mickymuis/drowbot/README.md

drowbot logo Drowbot
Drowbot is a polar drawing robot that uses a RaspberryPi-zero as its heart of processing.

pinout diagram pinout for the RJ-45 connector
