mickymuis/drowbot/report/report.tex

% !TEX TS-program = xelatex
% !TEX encoding = UTF-8 Unicode

\documentclass[a4paper,10pt]{article}

\usepackage[english]{babel}
\usepackage{graphicx}
\usepackage{subcaption}
\usepackage{wrapfig}
\usepackage{amsmath}
\usepackage[hidelinks]{hyperref}
\usepackage[margin=40mm]{geometry}

\hypersetup{
  unicode=true,
  pdftitle={Robotics paper},
  pdfsubject={Drowbot - A Suspended Polar Plotting Robot},
  pdfauthor={Micky Faas, Koen Putman},
  colorlinks=false,
  breaklinks=true
}
\usepackage{fontspec}
\defaultfontfeatures{Ligatures=TeX}
\usepackage[small,sf,bf]{titlesec}
% Times New Roman takes up less space so we can fit more text in fewer pages :)
\setromanfont{Times New Roman}
\setsansfont{Arial}
\setmonofont[Color={0019D4}]{Courier New}

% TODO: Add more citations in general because the paper is too long anyway
% TODO: clean the code a bit to make sure it's deliverable

% Converted logo SVG to eps so we lose the aliasing
\title{\vspace{-5.5em}
 \\ \vspace{.5em}
%\huge Drowbot
\Large \sffamily{A Suspended Polar Plotting Robot}}

% TODO: Whoops I don't know your student number
% No problem, I don't know it either :)
\author{Micky Faas (s1407937) \and Koen Putman (s1305557)}
\date{}

\begin{document}
\maketitle
\begin{abstract}
%TODO: Actually write this
% Micky: zo ouwehoer ik mijzelf dus een weg door het leven...
In the past, plotting-devices were usually very expensive specialised
equipment used by big printing studios.
% In recent years, the emergence of affordable embedded platforms such as Arduino and Raspberry Pi have given rise to a myriad of plotters that are available to the general public and DIY-community.
That changed with the emergence of affordable platforms like Arduino and the
Raspberry Pi, which have allowed the DIY-community to create a myriad of
affordable plotters for the general public.
Those plotters are used by hobbyists, tinkerers, print-makers, and artists that
want to explore the boundaries of man-machine synergy.
What most of these plotters have in common is that they are unidirectional
devices: they simply perform the drawing instructions they get from their
operator.
We introduce Drowbot, a bidirectional polar plotter.
By using optical feedback, Drowbot can expand, adapt and interpolate
directly on the canvas - allowing Drowbot to become a co-author rather than a tool.

%%% Original abstract from long ago
% There exist many different drawing- and writing robots. Examples
% include Axibot [1] or [2]. The most common constructions are either arm-based
% (single arm holding a pen) or have a plotter/CNC-style three-axis position pen.
% Practical implementation often utilize the GCode protocol to send drawing
% instructions to the robot; the robot itself lacks any ‘intelligence’, which basically
% makes it a printer/plotting-device. The ‘Maestrobot’ differentiates itself by being
% able to create its output untethered. It is equipped not only with a pen/marking-
% tool, but also with a simple optical sensor (infrared-led-photodiode). Using
% this sensor, the Maestrobot can ‘see’ what is already on the paper and use this
% information to decide where/what to draw next. Different algorithms could
% be suitable to add ‘intelligence’ to the robot’s drawing expertise. For example,
% cellular automata could be used to finish a given start sequence or the input could
% be combined with Perlin noise to create interesting textures. Eventually the
% robot could be used to perform certain difficult or tedious tasks in human-made
% art. These include repeating structures, fractals or extremely fine lines, given an
% algorithm specified by the artist.
% [1] https://www.axidraw.com/
% [2] https://www.thingiverse.com/thing:2349232
\end{abstract}

\section{Introduction}
\label{sec:intro}

% Micky: ik knip dit er even uit, we hebben *veel* teveel pagina's en dit staat ook soort-van in de abstract
%While some might consider drawing a distinctly human art form,
%many tools have been devised to assist in the process.
%In recent years there has been a shift to digital with drawing
%tablets and drawing software and it is not unusual for a drawing
%to never exist outside of the digital realm.
%This digital realm is very convenient, but why stop there.
%Our increasingly digital lives have brought us electronics that
%allow the digital to act in the real world, including the robot.

Many drawing robots have been devised to automate tedious and
repetitive parts of the artistic (printing-) process.
These include drawings arms and three-axis CNC-like solutions that
act as some form of plotter.
But we believe that robots do not have to be deterministic plotters
and wanted to see if they could interact with artwork and produce
drawings without pre-programmed or direct control.
Is it viable to give a drawing robot some agency to produce some
form of art on its own?

\section{Project Overview}
\label{sec:overview}
% Description and goals of the project

We set out to create a drawing robot that is partially controlled by
optical feedback.
With our limited amount of time and a live prototype presentation
on the horizon we had to set some constraints to make this possible.

Given that the live demo was held in a classroom the only viable drawing
surface was the blackboard, as transporting a large amount of surface
to draw on was infeasible.

Using the vertically mounted blackboard as surface and chalk as
end-effector seemed to have left us with a single viable approach:
using a suspended drawing platform or \emph{gondola} attached to the top corners of the
blackboard using cables, akin to a Delta 3D-printer but with fewer axes.
If we can vary the cable lengths and give the gondola a way to
disengage the chalk from the blackboard we end up with three
degrees of freedom.
Moreover, the camera on the gondola serves as a means to gather the
optical feedback we required.
We will provide an overview of the design in the next sections and
more details about our prototype design can be found in the appendix.

\subsection*{Related work and inspiration}
The class of plotters that includes our Drowbot is usually called \emph{polar plotter} after their internal use
of bipolar coordinates, which we will cover later on.
The \emph{Polargraph} \cite{polargraphsite} is probably the best known variant and this project also served as inspiration for some of the construction aspects of Drowbot,
but no code from this or any other existing polar plotter was used.
% TODO: figure out how to cite an in-document bibliography without warnings

%%% Code dependencies are probably pointless to list tbh
% The only library dependency of our code is the PIGPIO library for
% simplified GPIO and help with timing our signals, but replacing
% this would not be particularly hard.
% We also used the V4L2 drivers for the raspberry PI camera in order
% to grab images through the file descriptor interface.

% Micky: moved figure to appendix

Our prototype has a rather large physical presence as seen in Figure~\ref{fig:overview}.
In this section we will try and give an overview of the parts involved
while there is a more elaborate description in appendix \ref{sec:buildinst}.

\subsection*{Motors and cables}
% There is no better place to start than the reason why it (usually)
% does not fall apart.
The main body of these assemblies is mounted to the blackboard and
contains a stepper motor and a special pulley for the beaded chain.
We used the beaded chain because it is light and easy to hold firmly
on the pulley. That helps to ensure that it only moves when we want it to.

Both beaded chains connect to the middle of the gondola using ball-bearings.
This keeps the gondola upright regardless of the angle of the chains.
The chalk is placed in the tube that the bearings are mounted on so it is always
at the centre of the forces applied to to gondola.
Both the pulleys and the handles that connect to the bearing are 3D printed.
Designs for the 3D printed objects can be found on GitHub\cite{github}.

\subsection*{The gondola}
This ``moving platform'' is attached to the same chalk tube that we attached
the chains to.
It holds a good chunk of the electronics, like the Raspberry Pi Zero W
that we use to drive the entire thing and the camera we use to gather
optical feedback.
The gondola ``glides'' on the blackboard using nylon bolts as a form of
standoff or ``legs''.
Lifting the chalk to stop drawing is achieved by a mechanism that pushes the platform away from the
blackboard using a servo-motor.
To counteract the weight of the servo on the top of the platform
we added some counterweight to the bottom.

In order to power the electronics and send control signals back to the
motors up top, we need to run 7 separate wires. We made a
custom shield with an RJ45 socket on it, so we could conveniently run Cat 5e
cable to carry all of necessary signals.

\subsection*{Motor drivers and power delivery}
% Micky: Knip want ruimte
%On the other end of that Cat 5e cable is another piece of protoboard,
%the final piece of our design puzzle.

We used two DRV8825 drivers to simplify controlling the stepper motors.
These drivers allowed us to use a separate stronger power supply for
the motors while the rest of our electronics used a USB power supply.
This proved very useful when we needed to switch to stronger motors
to move and even hold the heavy platform.

\section{Functionality}
\label{sec:functionality}
% Micky: knip want ruimte
%While the physical design is impressive, the only thing it can do
%without software is hold its place on the board.
%The actual software component for this project is very light since
%driving the system is essentially just moving the servo between
%two preset positions and telling the drivers when to step and in
%which direction.

We will start this section by covering the core functionality and the
demo we built on top of that, before moving on to a short explanation
of some of the maths involved in the background.

% Micky: ja dit is niet netjes, maar het scheelt weer enorm veel ruimte.
%\subsection{Core functionality}
The Drowbot can interpret a section of the blackboard as a grid
and move feely within it using normal Cartesian coordinates.
For our demo we only use a very simple interface with a single
command telling it to move to specific coordinates while specifying
if it should draw or lift the chalk from the board, but much more
elaborate systems are technically in reach.

% Micky: moved figure to appendix

\subsubsection*{1D cellular automaton}

% TODO: cite stuff?
% Micky: added citation
% Micky: shorter rephrase
%We wanted a demonstration that shows a possible application of the
%optical feedback provided by the camera and with our relatively
%simple movement interface something simple like a one dimensional
%cellular automaton is a perfect fit.

The one-dimensional cellular automaton\cite{elemca} is the perfect
tool to demonstrate the application of optical feedback on the Drowbot.

We start by drawing a number of boxes on the board which can be
filled to provide a visual representation of the initial state.
After the initial state has been created the
Drowbot will read the initial state using the camera.
A user is then invited to enter a \emph{Wolfram code}\cite{elemca} of their liking
and the Drowbot will then draw the rest of the generations
using the user provided initial state and rule.

An image of a resulting drawing can be seen in Figure~\ref{fig:ca_res}.

% Micky: we're not making excuses :) And it saves space. (When did I switch to English anyway?)

%The boxes are filled with a Z pattern to save time while drawing.
%There are some extra diagonal lines in the image because the system
%for lifting the chalk to stop drawing was not perfectly tuned.

\subsubsection*{Dragon curve}

% TODO: cite stuff?
% Micky: added citation
The simple movement interface of Drowbot is very similar to
turtle graphics and we can emulate most of the turtle graphics
functionality with it.
We wanted to show how this robot can help people with drawing
repetitive structures like fractals, and have ported the turtle
graphics code for the \emph{Heighway dragon curve}\cite{dragon} to run on Drowbot.

The resulting image can be seen in Figure~\ref{fig:drag_curve}.

\subsubsection*{Maths}
% Problem solved (or more specifically, moved)
Moving the gondola over the board is done by varying the lengths of the
chains on both sides in order to reach the desired position.
So our coordinate system represents a position as two distances from
the steppers which are mounted in fixed positions.
This is the bipolar coordinate system~\cite{bipolar} we mentioned earlier,
which is very different from the Cartesian coordinates we use for our
drawing interface.
To handle the translation between these systems we have to calibrate
the device using measurements for the chain lengths and how far the
stepper motors are apart, as well as the length of a stepper motor
step.
When calibrated properly the precision of the system is about as good
as it gets for chalk on blackboard.

More details and a simple example can be found in Appendix~\ref{sec:maths}.

\section{Conclusion and discussion}
\label{sec:conclusion}

% Micky: yep, modesty and self-deprecation can be saved for a much-needed later occasion :)

%In some miraculous fashion we managed to achieve all the lofty goals
%we set for this project.
%We have a functioning drawing robot that can read something from
%the blackboard and act based on whatever it saw on its own without
%direct input.

%This project was a lot of fun, but it also ended up costing both
%member a large part of the month we spent creating this.

% Micky: this one comes right out of my collection of standard NT sentences I keep in a yar.
The design of the Drowbot was challenging yet rewarding experience
and we are glad to have met most, if not all, of the goals we had initially set.
Almost every step of the way we faced a new setback and almost all
of the initial parts of the design were replaced in the process.
The end result worked so much better than we could have dreamt,
especially considering all the setbacks.

Although we did end up with a working prototype, there are various obvious
improvements we have to make in order to get it closer to a production model.
Future work includes removing it from its blackboard and chalk
constraints and see what it can do on a medium that is
more controlled and easier to move in, such as ink on paper.
We also want to look for or devise more algorithms where the optical
feedback system could play a more significant role.

\begin{thebibliography}{9}
%TODO: MORE CITING
% Micky: Added Wolfram/1d CA and Dragon curve

\bibitem{polargraphsite}
  \textit{Polargraph}, Sandy Noble
  \\\url{http://www.polargraph.co.uk/}

\bibitem{github}
  \textit{Drowbot GitHub repository}, Micky Faas, Koen Putman
  \\\url{https://github.com/mickymuis/drowbot}

\bibitem{elemca}
Wolfram, Stephen:
\textit{``Statistical mechanics of cellular automata."}
In: Reviews of Modern Physics, Vol. 55.3: 601--644.
(1983)

\bibitem{dragon}
\textit{Dragon Cuve} on Wolfram Mathworld
\\\url{http://mathworld.wolfram.com/DragonCurve.html}

\bibitem{bipolar}
\textit{Bipolar Coordinates} on Wolfram Mathworld
\\\url{http://mathworld.wolfram.com/BipolarCoordinates.html}

\end{thebibliography}

\clearpage
\appendix

\section*{Photography}

\begin{figure}[h!]
  \centering
  \begin{subfigure}[t]{0.55\textwidth}
    \centering
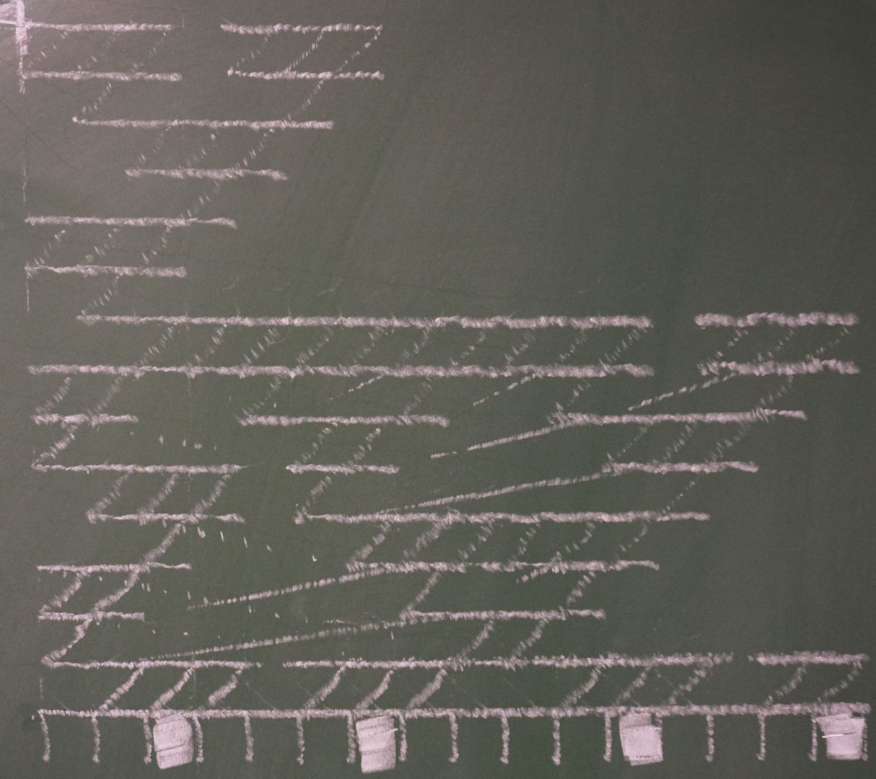
[picture p1: report/img/ca_res.jpg]
    
    \caption{Result from drawing a cellular automaton with Wolfram code 22}
    \label{fig:ca_res}
  \end{subfigure}
  \begin{subfigure}[t]{0.4\textwidth}
    \centering
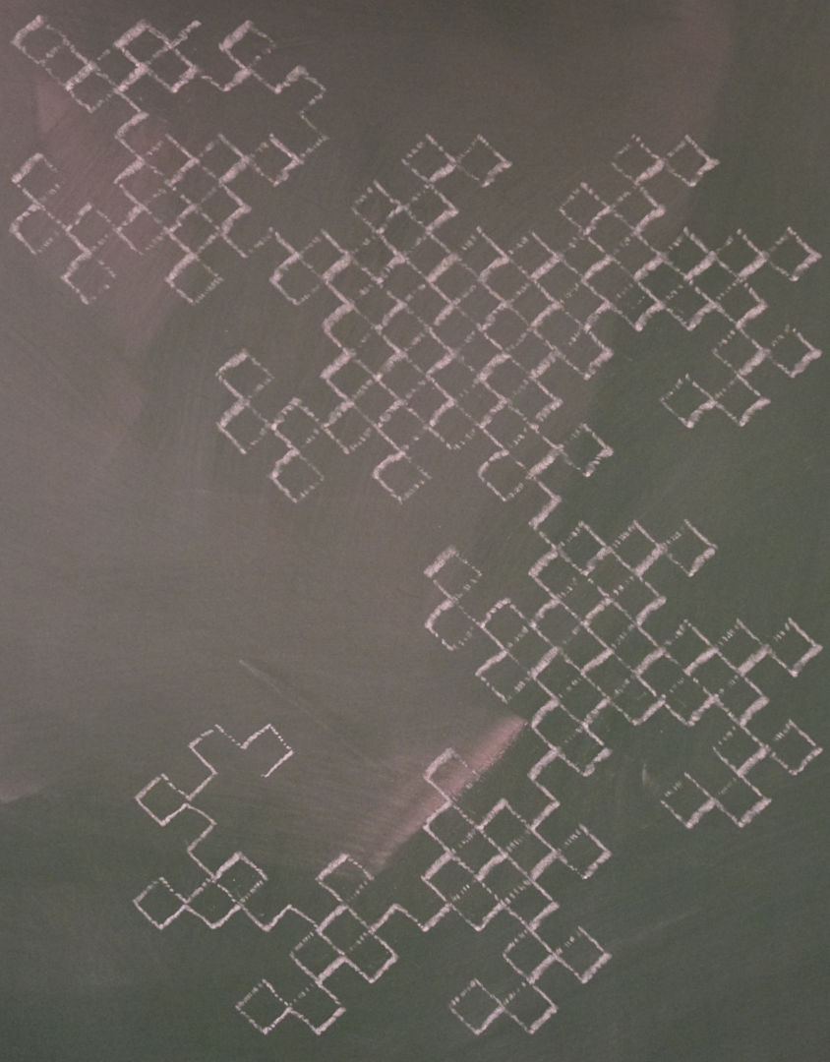
[picture p2: report/img/dragon_curve.jpg]
    
    \caption{A section of the dragon curve}
    \label{fig:drag_curve}
  \end{subfigure}
\end{figure}

\begin{figure}[h!]
  \centering
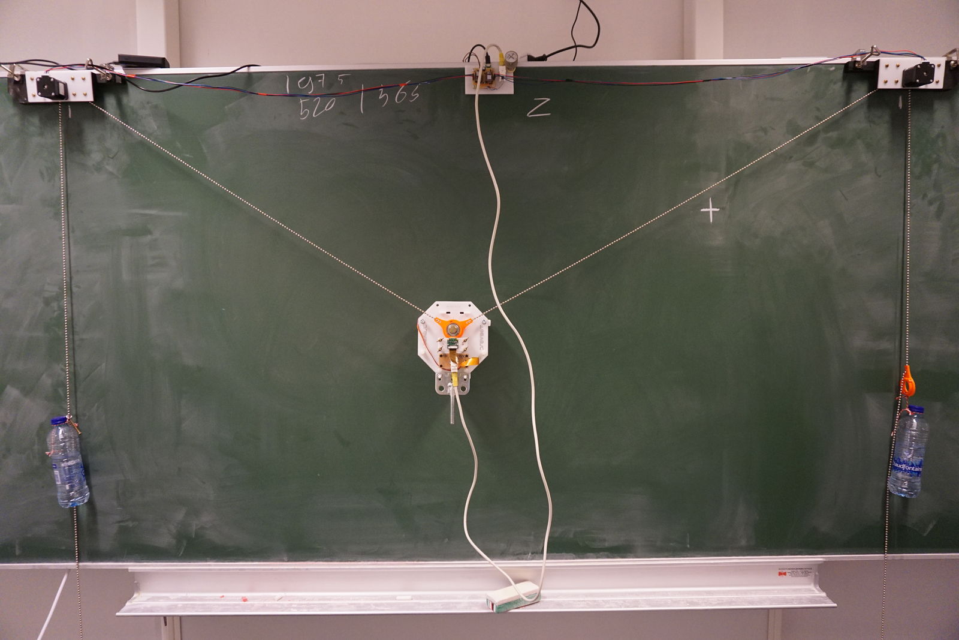
[picture p3: report/img/overview_rs.jpg]
  
  \caption{Drowbot deployed on a blackboard}
  \label{fig:overview}
\end{figure}

% Appendix I: An overview of the system requirements.
\clearpage
\section{System requirements}
\label{sec:sysreq}
The general requirements are a lot of time on your hands and a wide
arrangement of tools, but we will go into more details about what
we used in this section.

% TODO: Is this comprehensive or did I forget some things
\subsection*{Motors and beaded chains}
\begin{itemize}
  \item A motor mount that can be clamped to the blackboard. We created brackets from wood and used five jigsaw clamps.
  \item NEMA 17 stepper motors (we used 1.8$^\circ$/step, 0.55N/M, 1.7A)
  \item Beaded chains (we used chrome, 4.4mm beads, 2mm apart)
  \item Several 3D printed parts (.stl available on GitHub)
  \begin{itemize}
    \item beaded chain pulleys for the stepper motors
    \item levers to attach the chains to bearings on the platform
    \item eyelets attach a counterweight to the chain
  \end{itemize}
  \item Counterweights (we used water bottles filled to aprox. 250 mL)
\end{itemize}

\subsection*{The gondola}
\begin{itemize}
  \item The platform itself (printable template SVG available)
  \item A Raspberry Pi Zero W or equivalent with
  \begin{itemize}
    \item at least 5 GPIO pins (2x step, 2x dir, 1x servo PWM)
    \item a picamera or other camera with V4L2 drivers
    \item an SD card with a Linux-based ARM OS (e.g. archlinuxarm)
    \item the ability to compile and use the PIGPIO library (or
          willingness to port the code to use some other GPIO library)
  \end{itemize}
  \item A custom shield for the Pi with
  \begin{itemize}
    \item A Female RJ45 connector to receive power and send signals
    \item Some way to connect the servo to power and the PWM pin
    \item Connections to several other GPIO pins for motor control
    \item Power distribution to the Pi and servo
    \item A 3.3V signal to send up from the Pi to the motor drivers
  \end{itemize}
  \item A servo to lift the chalk of the blackboard (like a MG996R). The template may need to be adapted for differently sized motors.
  \item A spring powered bar for the servo to push against. We used a bar made of 4 mm acrylate, with two M6 holes that line up with the corresponding holes in the gondola. Two springs and two long M6 hex bolts with ~30 mm flat shaft are also required.
  \item A camera mount for your camera. We used a PiCamera held by a piece of acrylate.
  \item A tube to mount the end-effector in (we used 10 mm chalk).
  \item Ball bearings to hold the chain handles. We used bearing that could fit over a 12 mm tube, measuring 32x10 on the outside. The OpenSCAD template can be easily modified to accommodate other sizes.
  \item M6 Nylon bolts to use as standoffs for the platform
  \item Standoffs to attach the Pi and the custom shield
  \item Many other nuts and bolts for various purposes, mainly to attach the camera (M3 for the platform, the PiCamera holes are M2).
  \item Some weight to hold the bottom of the platform down
\end{itemize}

\subsection*{Motor drivers and power delivery}
\begin{itemize}
  \item A power supply for the Pi/Servo (we used 5V USB with at least 2A)
  \item A motor power supply (we used one with 19V, 3.16A)
  \item A 100 \textmu F capacitor to smooth current between motor power and ground
  \item Two DRV8825 Stepper Motor Drivers (or equivalent)
  \item Two RJ45 sockets to attach the Cat 5e cable
  \item We used protoboard to create a shield for the RasberryPi in order to route the used pins to the RJ45. The motors drivers are mounted on a second protoboard, also containing a female RJ45 socket and an micro-usb socket for 5V supply.
\end{itemize}

%Appendix II: Complete and very clear instructions on how to get your
% demo working.
\clearpage
\section{Build instructions}
\label{sec:buildinst}

\subsection{Building the gondola}

\begin{figure}[h!]
  \centering
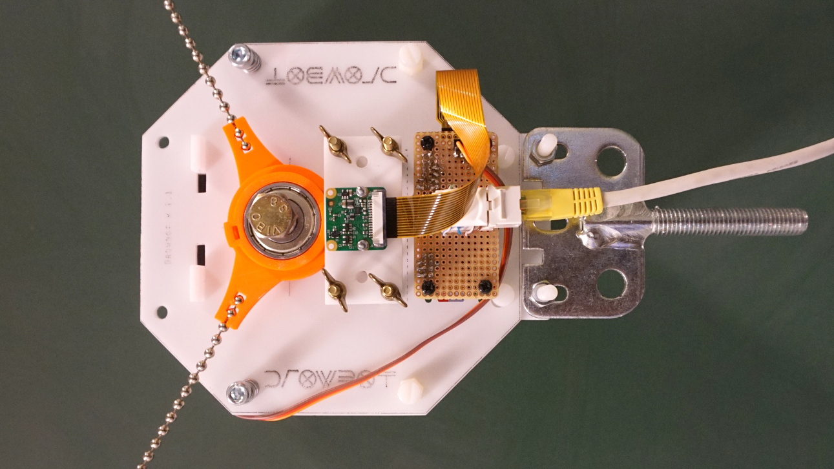
[picture p4: report/img/gondola.jpg]
  
  \caption{Assembled and attached gondola}
  \label{fig:gondola}
\end{figure}

\textbf{Step 1.} The gondola consists of a baseplate from acrylate with several components mounted on top of it.
The first step is to cut/drill out the baseplate from 4 mm acrylate using the template in Figure~\ref{fig:baseplate}. An SVG with more accurate dimensions can be found on GitHub\cite{github} and printed \emph{mirrored} using a \emph{laser} printer. We then transfer the print to a piece of well-sanded acrylate using the thinner-method\footnote{In a thinner-print, thinner is used to dissolve the cellulose in the paper and firmly attach the remaining toner to the printed surface.}.

\textbf{Step 2.} The next step is to mount the electronics. The camera is mounted on a piece of rectangular acrylate, with holes that correspond to the holes on the baseplate marked ``camera''. Make the appropriate holes to fit your camera. The assembly is then mounted using long M3 bolts and winged nuts to set the desired distance. The RaspberryPi (with shield, see below) can be put on M3 standoffs in the corresponding holes.

\textbf{Step 3.} The servo is fit at the top, but the precise method depends on the servo used. In the design, two rectangles are marked to be cut out. These cut-outs can be used to either fit ``hooks'' from acrylate that hold the servo, or simply use tie-wraps. The hooks we used are matched to the holes in the servo, which accommodate four M3 bolts to hold the servo in place.

\textbf{Step 4.} The four most outward M6 holes are for the legs of gondola. The bottom legs are simple M6 bolts fitted with nylon cap-nuts. The upper legs can be moved by the servo to lift the pen. For this we have fit a thin strip of acrylate with corresponding holes to spring loaded bolts. We use slightly longer bolts here that have a partially thread-less shaft in order to move through the holes without friction.

\textbf{Step 5.} The lower two holes can be used to fit counterweight to the gondola. We needed to use approximately 200 grams. Note that the further the weight is placed \emph{above} the gondola, the more pressure it applies to the bottom.

\textbf{Step 6.} Finally we attach the pen holder in the 12 mm hole of the baseplate. The pen holder conists of two ball-bearings measuring 32x10 mm, which are press-fit over the tube. The bearings are attached to the ball-chain using 3d-printed levers (orange on the photo). Lastly some means is needed to secure the pen in the tube. The chalk we used fitted exactly in the 10 mm inner diameter of the tube. We used an M10 bolt (with thread cut on the inside of the tube) to adjust the depth of the chalk.

% Micky: ik heb maar PNG gedaan want ik had geen zin om met LaTeX te vechten om mijn SVGs...
% Koen:  Inkscape kan naar eps exporteren, dus dat is mijn standaard strategie
\begin{figure}[p]
  \centering
  
  \caption{Design template for the gondola baseplate}
  \label{fig:baseplate}
\end{figure}

\begin{figure}[p]
  \centering
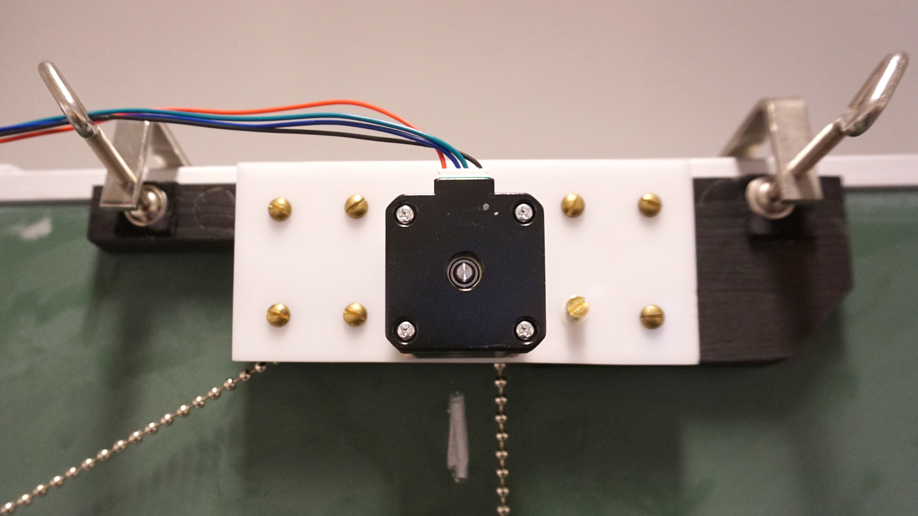
[picture p5: report/img/motorsusp.jpg]
  
  \caption{Assembled and attached motor suspensions}
  \label{fig:motors}
\end{figure}

\subsection{Building and attaching the motor suspensions}

The motor suspensions in are simple brackets (in our case, of wood) that hold an acrylic NEMA-17 faceplate. The thickness of the brackets is approximately 30 mm and should be chosen in such way that the pulleys almost touch the board. The brackets are also cut in such way that the chain can move unobstructed to one side (thus, the left and right brackets are mirrored).

Mounting the brackets depends on the medium it has to print on. Jigsaw clamps are a practical solution for mounting to (black-)boards with a thickness between 10 and 30 mm.

You can see a fully assembled example in Figure~\ref{fig:motors}.

\subsection{Wiring the RaspberryPi shield}

The shield for the RaspberryPi is relatively simple as it is simple used to route a number of GPIO pins to the servo and RJ45 socket. Figure \ref{fig:pinout} provides a template for how to connect the different pins that we used to the RJ45 socket. In addition, a three-pin header is used to plug the servo motor to the board.

\begin{figure}[h!]
  \centering
  
  \caption{Pin-out used for the RJ45 wiring}
  \label{fig:pinout}
\end{figure}

\subsection{Constructing and wiring the driver assembly}

\begin{figure}[h!]
  \centering
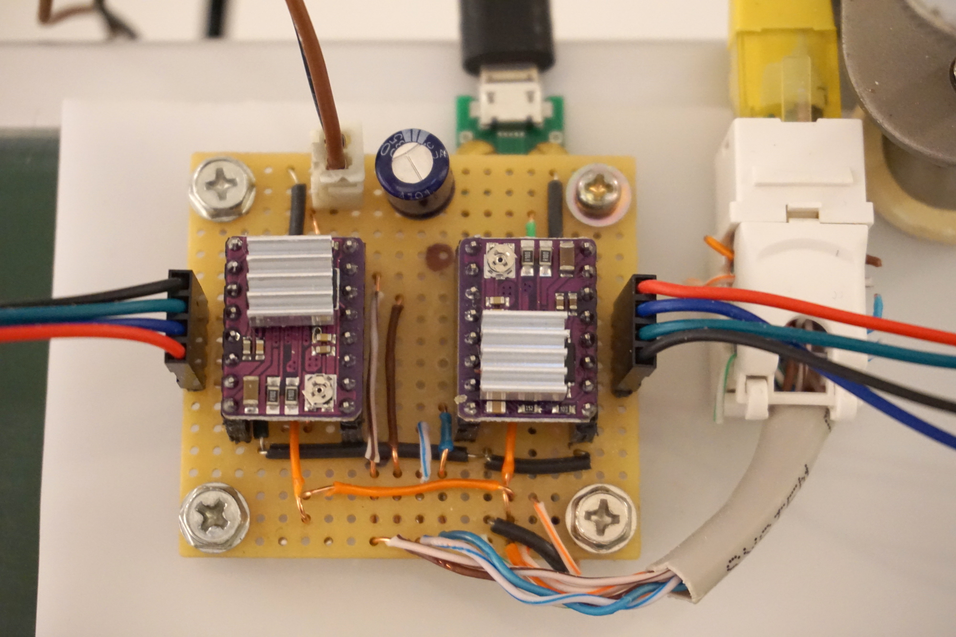
[picture p6: report/img/driverboard.jpg]
  
  \caption{Driver board with two DRV8825s, female RJ45, USB-power and separate motor power.}
  \label{fig:driverboard}
\end{figure}

The driver board can be attached to the top of the drawing surface and connects the gondola to the motors as well as power to the gondola. The main components are two pre-fabricated DRV8825 stepper-motor driver boards. Different boards could be used and it is necessary to consult the pinout of the drivers in question to wire them correctly to the power input and signals from the gondola. The connection with the gondola is made with the other side of the UTP cable that connects to the shield on the RaspberryPi. We decided to utilize two separate power supplies: one for the motors and one for the RaspberryPi and servo. In this design, one 5V line runs down to the gondola, while the RaspberryPi provides 3.3V back to power the logic circuit of the drivers. In hindsight, it is also possible to power the driver logic using the same 5V from the USB power supply, so that would free up one pin on the RJ45.

% TODO: I forgot how detailed this had to be but it sure needs to happen
% TODO: ADD SPECS FOR EVERYTHING, or at least some wiring info

\clearpage
\begin{figure}[t]
  \centering
  
  \caption{Mapping bipolar coordinates to Cartesian coordinates.}
  \label{fig:maths}
\end{figure}
\section{Maths}
\label{sec:maths}

To elaborate on the maths we have provided a small example image
in Figure~\ref{fig:maths}.
These maths are in no way advanced, but we think they are interesting
enough to warrant explaining in more detail.
The lines and labels in the example are colour coded so we will start
by explaining what they represent.

The black labels represent fixed constant values with $L$ and $R$
representing the stepper motors, and $Top$ the distance between them.

The blue $Left$ and $Right$ represent the chain lengths, the variables
we control directly.

The red $P$ represents the platform at position $(X,Y)$ in Cartesian
coordinates.

One of the nice constraints in our case is that $P$ will never be
left of $L$ or right of $R$ and will always be below $L$ and $R$ due
to gravity. This simplifies some of the calculations.

To calibrate our system we want to determine the position of $P$ based
on our measurements of $Left$, $Right$, and $Top$.
We will start by calculating $Y$, the height of the triangle $L,R,P$.

To get the height of a triangle for which you know all side lengths.
You can start by calculating its area using Heron's formula:
$$s = \frac{Top + Left + Right}{2}\qquad Area = \sqrt{s(s-Top)(s-Left)(s-Right)}$$
%
Now we can solve the equation for the area of a triangle for the height
and obtain $Y$:
$$Area = \frac{height \times base}{2} = \frac{Y \times Top}{2}
\quad \rightarrow \quad Y = \frac{2 \times Area}{Top}$$
%
We can then obtain the position of $X$ using the Pythagorean theorem:
$$X = \sqrt{Left^2 - Y^2}$$

Now that we know how to get from side length to coordinates we can
also go in the opposite direction and calculate how long $Left$ and
$Right$ need to be to get $P$ to a given $X,Y$.
This is another simple application of the Pythagorean theorem:
$$Left = \sqrt{X^2 + Y^2},\ Right = \sqrt{(Top - X)^2 + Y^2}$$

So our internal position of $P$ is not $(X,Y)$, but actually the
integer values for $(Left,Right)$ which most closely approximate $(X,Y)$.

This all seems relatively simple until you want to draw a smooth
straight line between two Cartesian coordinate points.
The resulting step sequence in the bipolar system is far from smooth
and if you simply smooth the movement between the source and target
chain lengths you will probably end up with curved lines.

Sadly we didn't have enough time to figure out an elegant solution so
we ended up interpolating the line using very small movements in the
Cartesian system, but in the future we would like to figure out if
there is a nice way to handle this.

% The interface we used for our demonstration was based on moving
% in straight lines between two positions in the Cartesian coordinate
% system, which is not as trivial as it might seem when translated to
% our bipolar coordinate system.

% This disconnect means that moving from one Cartesian coordinate
% to another in a straight line does not translate in a smooth linear
% change for the bipolar system.

% % Micky: I'm not saying we should completely leave this part out,
% % but it may not be necessary to go into detail about our weaknesses.
% % I know, I also have major problems leaving out information and feeling dishonest for it.
% % However, you already pointed out the approximation in the paragraph above
% % and I think we can leave it at that. Still too many pages...

% Sadly we lacked the time to properly analyse and solve this in an
% elegant fashion so we went with the other approach to change the
% straight line into a series of small line segments in Cartesian
% coordinates and translating those to bipolar coordinates so the
% overall movement seems to be straight.
% % Even though we did not use any microstepping for our prototype
% % while our drivers did support it we already had a resolution of
% % about half a millimetre per step and considering how relatively
% % inaccurate chalk is the difference between this interpolation
% % and an actual straight line is absolutely invisible.

\end{document}
