mickymuis/drowbot/report/img/gondola.png

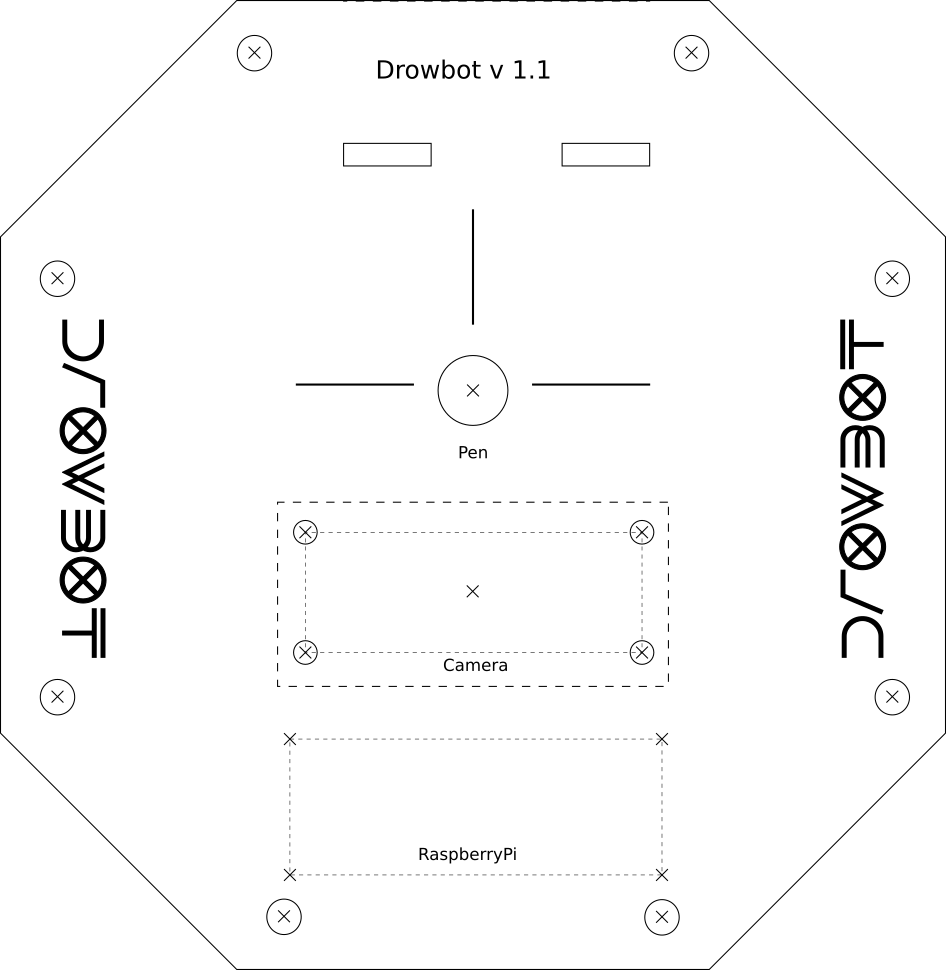
report/img/gondola.png
