mickymuis/drowbot/report/img/pinout.png

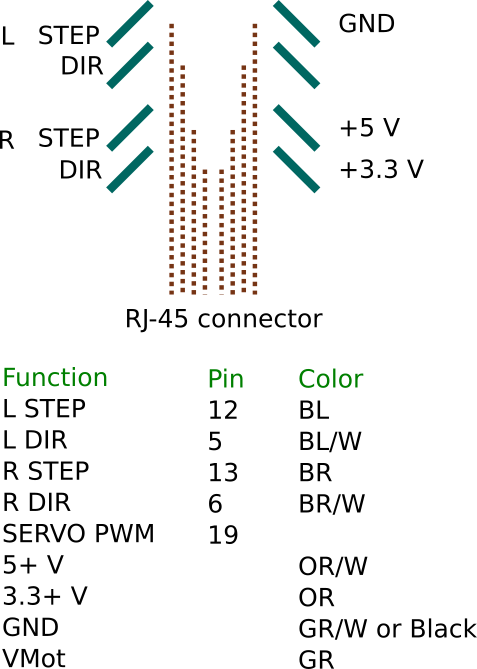
report/img/pinout.png
