mickymuis/drowbot/parts/drowbot bearing_lever right.stl

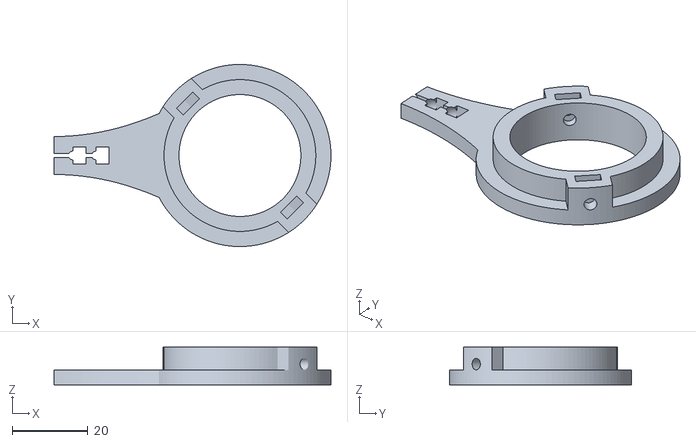
[picture p16: CAD file, 2019-05-02]
parts/drowbot bearing_lever right.stl
73.0 x 48.0 x 10.0
