mickymuis/drowbot/parts/drowbot ballchain_eyelet.stl

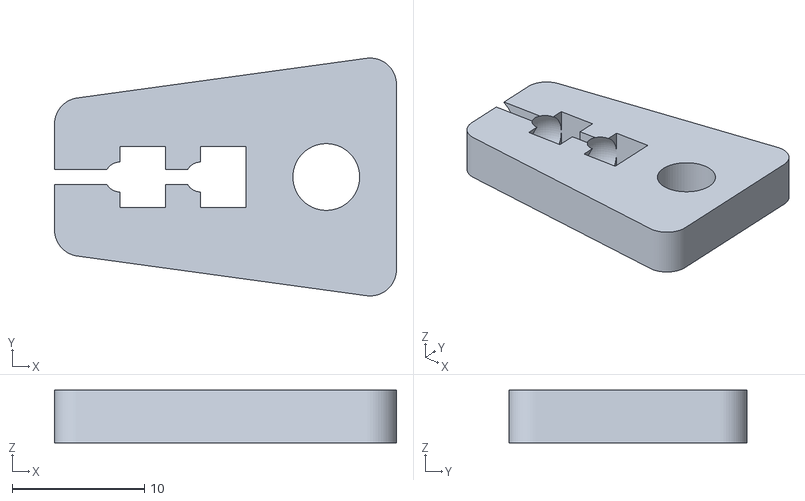
[picture p17: CAD file, 2019-04-30]
parts/drowbot ballchain_eyelet.stl
25.9 x 18.0 x 4.00
