mickymuis/drowbot/parts/drowbot 15 ball pulley.stl

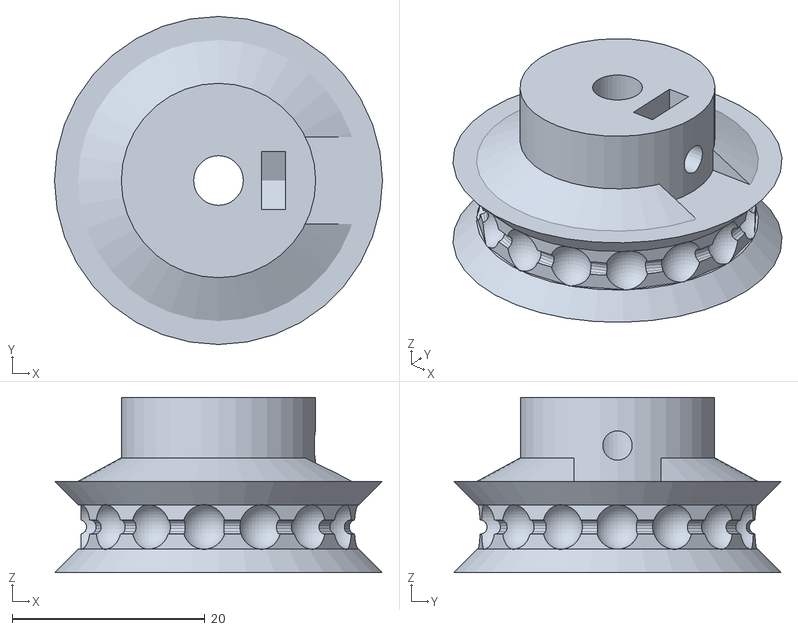
[picture p18: CAD file, 2019-04-29]
parts/drowbot 15 ball pulley.stl
34.0 x 34.0 x 18.2
