mickymuis/drowbot/(list of files, cad)

Other CAD files:
parts/drowbot bearing_lever left.stl
