mickymuis/drowbot/code/move.c

#include <stdio.h>
#include <math.h>
#include "move.h"
#include "driver.h"
#include "calibration.h"

#define X_MAX LEN_TOP - (SX * 2)
#define Y_MAX (1300 * 1000)/STEP_MCM

int cx = 0, cy = 0;

int get_x(){return cx;}
int get_y(){return cy;}
int get_x_max(){return X_MAX;}
int get_y_max(){return Y_MAX;}

void calc_target(const int x, const int y, int * left, int * right){
  int tx = SX + x;
  int ty = SY + y;
  int ta = LEN_TOP - tx;
  double b = sqrt(tx * tx + ty * ty);
  double c = sqrt(ta * ta + ty * ty);
  *left  = (int)round(b);
  *right = (int)round(c);
}

void move_set_coords(const int x, const int y){
  cx = x;
  cy = y;
  int l,r;
  calc_target(x, y, &l, &r);
  drv_set_pos(l, r);
}

int move_ask_for_coords(){
  int x, y;
  fprintf(stderr, "Enter coordinates or -1 -1> ");
  if (scanf("%d%d", &x, &y) != 2)
    return -1;
  if (x != -1 && y != -1)
    move_set_coords(x, y);
  return 0;
}

int move_init(){
  if(drv_init(DIR_L, DIR_R))
    return -1;
  drv_set_pos(LEN_LEFT, LEN_RIGHT);
  return 0;
}

void move_term(){
  move_to(0,0,0);
  drv_term();
}

void calc_target_f(const double x, const double y, int * left, int * right){
  double tx = SX + x;
  double ty = SY + y;
  double ta = LEN_TOP - tx;
  double b = sqrt(tx * tx + ty * ty);
  double c = sqrt(ta * ta + ty * ty);
  *left  = (int)round(b);
  *right = (int)round(c);
}


#define MOVE_FSCALE 1.0

// int move_to_s(const int x, const int y, const int draw){
int move_to(const int x, const int y, const int draw){
  if (x < 0 || x > X_MAX || y < 0 || y > Y_MAX){
    fprintf(stderr, "Error: target coordinates out of bounds\n");
    return -1;
  }

  int xd = x - cx,
      yd = y - cy;
  int xa = abs(xd),
      ya = abs(yd);
  int dx = (xd < 0)? -1: 1,
      dy = (yd < 0)? -1: 1;

  double xrat = 1.0, yrat = 1.0;
  if (xa == 0 || ya == 0){

  } else if (xa > ya)
    yrat = (double)ya/xa;
  else
    xrat = (double)xa/ya;

  // calc_target_f(x,y,&left,&right);

  int el = 0, er = 0;
  calc_target(x,y,&el, &er);
  drv_set_draw(draw);

  fprintf(stderr, "Moving %d %d->%d %d (%d %d -> %d %d)\n",
                  cx, cy, x, y, drv_lpos(), drv_rpos(), el,er);

  double tx = cx, ty = cy,
        dxf = (dx * xrat)/MOVE_FSCALE,
        dyf = (dy * yrat)/MOVE_FSCALE;
  while (drv_lpos() != el || drv_rpos() != er){
    int left = 0, right = 0;
    if ((xd < 0 && tx > x) || (xd > 0 && tx < x))
      tx += dxf;
    if ((yd < 0 && ty > y) || (yd > 0 && ty < y))
      ty += dyf;
    calc_target_f(tx, ty, &left, &right);
    drv_new_step_to(left, right);
  }

  cx = x;
  cy = y;
  return 0;
}


//Some older code and some initial ideas for doing move in a background thread
#if 0
#include <pthread.h>
typedef struct move{
  int x,y,draw;
} move_t;

int moving = 0;
pthread_t move_thread = {0};
pthread_mutex_t queue_lock = PTHREAD_MUTEX_INITIALIZER;

#define MAX_MOVES 1 << 8
int q_head = 0, q_tail = 0;
move_t move_q[MAX_MOVES];


int move_done(){
  return moving == 0 && q_head == q_tail;
}


void rebuild_coords(){
  double s = (double)(LEN_TOP + drv_lpos() + drv_rpos())/2.0;
  double A = sqrt(s * (s-LEN_TOP) * (s-drv_lpos())* (s-drv_rpos()));
  double sy = (2 * A)/LEN_TOP;
  double sx = sqrt(drv_lpos() * drv_lpos() - sy * sy);
  cx = (int)round(sx);
  cy = (int)round(sy);
}

int move_to(const int x, const int y, const int draw){
  if (x < 0 || x > X_MAX || y < 0 || y > Y_MAX){
    fprintf(stderr, "Error: target coordinates out of bounds\n");
    return -1;
  }
  int left = 0, right = 0;
  calc_target(x,y,&left,&right);

  fprintf(stderr, "Moving %d %d->%d %d (%d %d -> %d %d)\n",
                  cx, cy, x, y, drv_lpos(), drv_rpos(), left, right);

  if (drv_step_to(left, right, draw)){
    fprintf(stderr, "Warning: Positional info is probably inaccurate\n");
    rebuild_coords();
    return -1;
  }
  cx = x;
  cy = y;
  return 0;
}

int move_fg(const int x, const int y, const int draw){
  if (x < 0 || x > X_MAX || y < 0 || y > Y_MAX){
    fprintf(stderr, "Error: target coordinates out of bounds\n");
    return -1;
  }
  int left = 0, right = 0;
  calc_target(x,y,&left,&right);

  fprintf(stderr, "Moving %d %d->%d %d (%d %d -> %d %d)\n",
                  cx, cy, x, y, drv_lpos(), drv_rpos(), left, right);

  if (drv_step_to(left, right, draw)){
    fprintf(stderr, "Warning: Positional info is probably inaccurate\n");
    rebuild_coords();
    return -1;
  }
  cx = x;
  cy = y;
  return 0;
}
#endif
