mickymuis/drowbot/code/test_move.c

#include <stdio.h>
#include "driver.h"
#include "move.h"

int main(){
  if (move_init())
    return -1;

  int x,y,draw;

  fprintf(stderr, "Do you want to provide starting coordinates[y/N]>");
  if (getchar()=='y')
    move_ask_for_coords();


  while (1){
    fprintf(stderr, "%5d %5d left right draw?>",
                     get_x(), get_y());
    if (scanf("%d%d%d",&x, &y,&draw) !=3 )
      break;
    if (x <  0 || y < 0)
      break;
    move_to(x, y, draw);
  }

  move_term();
  return 0;
}
