mickymuis/drowbot/code/calibration.h

//Necessary constants
#define DIR_L           1
#define DIR_R          -1
#define LEN_TOP      4082
#define LEN_LEFT     1192
#define LEN_RIGHT    3122
#define SX           1021
#define SY            613
//Some of the source values
#define STEP_MCM      458
#define MM_TOP       1870
#define MM_LEFT       546
#define MM_RIGHT     1430
#define MM_SX         468
#define MM_SY         281
