mickymuis/drowbot/(commit log)

2019-04-29 Added SCAD files for (some of) the 3d printed parts
    [ballchain_eyelet.scad, ballchain_pulley.scad, bearing_lever.scad, drowbot 15 ball pulley.stl]
2019-04-30 More parts!
    [drowbot ballchain_eyelet.stl, drowbot bearing_lever left.stl, drowbot bearing_lever right.stl]
2019-05-02 Added pinout
    [drowbot bearing_lever right.stl]
2019-05-02 Switched L and R in the pinout
2019-05-02 Switched L and R in the pinout again lol
2019-05-05 Base code for using GPIO and the camera (with remote GUI)
2019-05-06 Update driver, add calibration/motion, some details on maths
2019-05-14 Various changes to the demo code and an attempt to fix movement
    [calibration.h, driver.c, driver.h, imgproc.h, live_demo.c, move.c, move.h, move_fake.c]
2019-05-25 Small bug fix in code that will probably never be used
    [move.c]
2019-05-27 Written new abstract
    [ballchain_eyelet.scad, bearing_lever.scad]
